macsawall/dspic33-mcu/docs/dspic33ev256gm102/Pinout.png

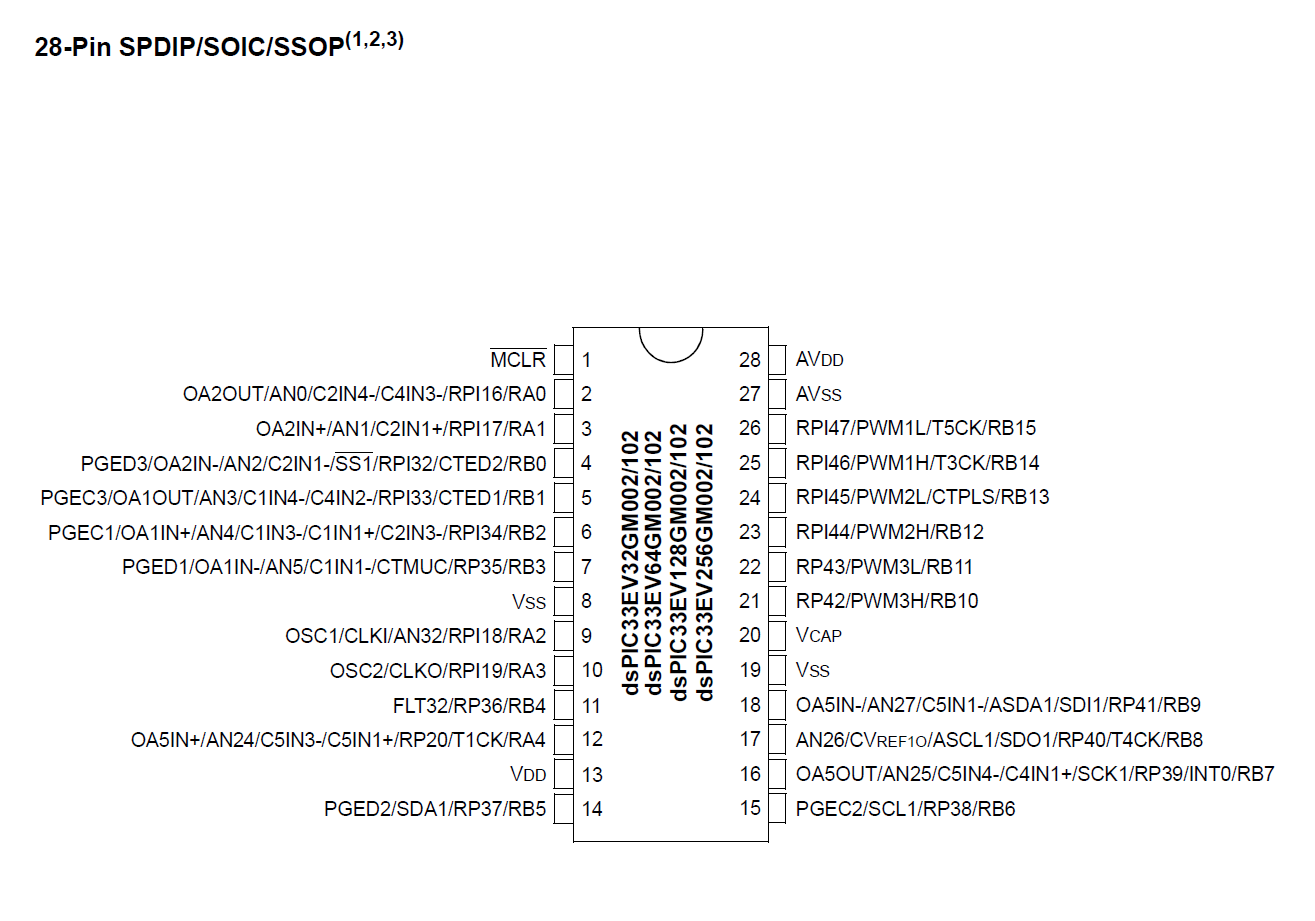
docs/dspic33ev256gm102/Pinout.png
