macsawall/dspic33-mcu/KiCad/dspic33ev256gm102/BOM_dspic33ev256gm102.ods

Reference | Quantity | Value | Footprint | Part # | Link
C2 | 1 | 10uF | Capacitor_SMD:C_1206_3216Metric | CGA5L1X7R1C106K160AC | https://www.digikey.com/product-detail/en/tdk-corporation/CGA5L1X7R1C106K160AC/445-12902-1-ND/3954568
C4 C3 C1 | 3 | 100nF | Capacitor_SMD:C_0603_1608Metric | CL10B104KO8NNNC | https://www.digikey.com/product-detail/en/samsung-electro-mechanics/CL10B104KO8NNNC/1276-1005-1-ND/3889091
D1 D2 | 2 | BLUE LED | LED_SMD:LED_0603_1608Metric | APT1608QBC/D | https://www.digikey.com/product-detail/en/kingbright/APT1608QBC-D/754-1434-1-ND/2163792
D3 D4 D5 | 3 | RED LED | LED_SMD:LED_0603_1608Metric | APT1608SURCK | https://www.digikey.com/product-detail/en/kingbright/APT1608SURCK/754-1123-1-ND/1747840
D6 D7 | 2 | GREEN LED | LED_SMD:LED_0603_1608Metric | APT1608CGCK | https://www.digikey.com/product-detail/en/APT1608CGCK/754-1116-1-ND/1747833/?itemSeq=334077280
J1 J2 J3 J4 J5 J6 J7 | 7 | Conn_01x07 | Connector_PinHeader_2.54mm:PinHeader_1x07_P2.54mm_Vertical | TSW-107-07-L-S | https://www.digikey.com/product-detail/en/samtec-inc/TSW-107-07-L-S/SAM1031-07-ND/1101420
J10 | 1 | USB-PWR | Connector_PinHeader_2.54mm:PinHeader_1x05_P2.54mm_Vertical | 2586 | https://www.digikey.com/product-detail/en/pololu-corporation/2586/2183-2586-ND/10450593
J8 J9 | 2 | FTDI, PICkit3 | Connector_PinHeader_2.54mm:PinHeader_1x06_P2.54mm_Vertical_SMD_Pin1Right | TSM-106-01-L-SV | https://www.digikey.com/product-detail/en/samtec-inc/TSM-106-01-L-SV/SAM10805-ND/2708007
JP2 JP1 | 2 | Jumper_NO_Small | Jumper:SolderJumper-2_P1.3mm_Open_Pad1.0x1.5mm | CRCW06030000Z0EAHP | https://www.digikey.com/product-detail/en/vishay-dale/CRCW06030000Z0EAHP/541-0-0SBCT-ND/2222749
R1 R2 | 2 | 82 | Resistor_SMD:R_0603_1608Metric | CRGP0603F82R | https://www.digikey.com/product-detail/en/te-connectivity-passive-product/CRGP0603F82R/A130403CT-ND/8578235
R3 R4 R5 | 3 | 150 | Resistor_SMD:R_0603_1608Metric | CRGP0603F150R | https://www.digikey.com/product-detail/en/te-connectivity-passive-product/CRGP0603F150R/A130406CT-ND/8578238
R6 R7 | 2 | 143 | Resistor_SMD:R_0603_1608Metric | CRCW0603143RFKEAHP | https://www.digikey.com/product-detail/en/vishay-dale/CRCW0603143RFKEAHP/541-143SCT-ND/5326821
R8 R9 R10 R11 R12 R13 R14 | 7 | 4.7k | Resistor_SMD:R_0603_1608Metric | CRGP0603F4K7 | https://www.digikey.com/product-detail/en/te-connectivity-passive-product/CRGP0603F4K7/A130424CT-ND/8578256
R15 | 1 | 470 | Resistor_SMD:R_0603_1608Metric | CRCW0603470RFKEAHP | https://www.digikey.com/product-detail/en/vishay-dale/CRCW0603470RFKEAHP/541-470SCT-ND/2826020
R16 | 1 | 10k | Resistor_SMD:R_0603_1608Metric | CRCW060310K0FKEAHP | https://www.digikey.com/product-detail/en/vishay-dale/CRCW060310K0FKEAHP/541-10-0KSCT-ND/2222780
SW1 | 1 | SW_SPST | digikey-footprints:Switch_Tactile_SMD_6x6mm | PTS645SM43SMTR92 LFS | https://www.digikey.com/product-detail/en/c-k/PTS645SM43SMTR92-LFS/CKN9112CT-ND/1146934
SW2 | 1 | SW_SPST | digikey-footprints:Switch_Tactile_SMD_6x6mm | PTS645SK50SMTR92 LFS | https://www.digikey.com/product-detail/en/c-k/PTS645SK50SMTR92-LFS/CKN9087CT-ND/1146813
SW3 | 1 | SW_SPST | digikey-footprints:Switch_Tactile_SMD_6x6mm | PTS645SL50SMTR92 LFS | https://www.digikey.com/product-detail/en/c-k/PTS645SL50SMTR92-LFS/CKN9088CT-ND/1146811
SW4 | 1 | SW_DIP_x04 | Button_Switch_SMD:SW_DIP_SPSTx04_Slide_9.78x12.34mm_W8.61mm_P2.54mm | 1-1825059-7 | https://www.digikey.com/product-detail/en/te-connectivity-alcoswitch-switches/1-1825059-7/1-1825059-7-ND/1202121
U1 | 1 | dspic33ev256gm102 | Package_SO:SSOP-28_5.3x10.2mm_P0.65mm | dsPIC33EV256GM102-E/SS | https://www.mouser.com/ProductDetail/Microchip-Technology/dsPIC33EV256GM102-E-SS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
 | 4 |  | HEX STANDOFF #4-40 NYLON ½" | 1902C | https://www.digikey.com/product-detail/en/keystone-electronics/1902C/36-1902C-ND/61868
 | 1 |  | ENCLOSURE | CU-1941 | https://www.digikey.com/product-detail/en/CU-1941/377-2068-ND/439228/?itemSeq=334078929
