macsawall/dspic33-mcu/KiCad/dspic33ev256gm102/dspic33ev256gm102.kicad_pcb

## KiCad design KiCad/dspic33ev256gm102/dspic33ev256gm102.kicad_pcb (2021-11-13)

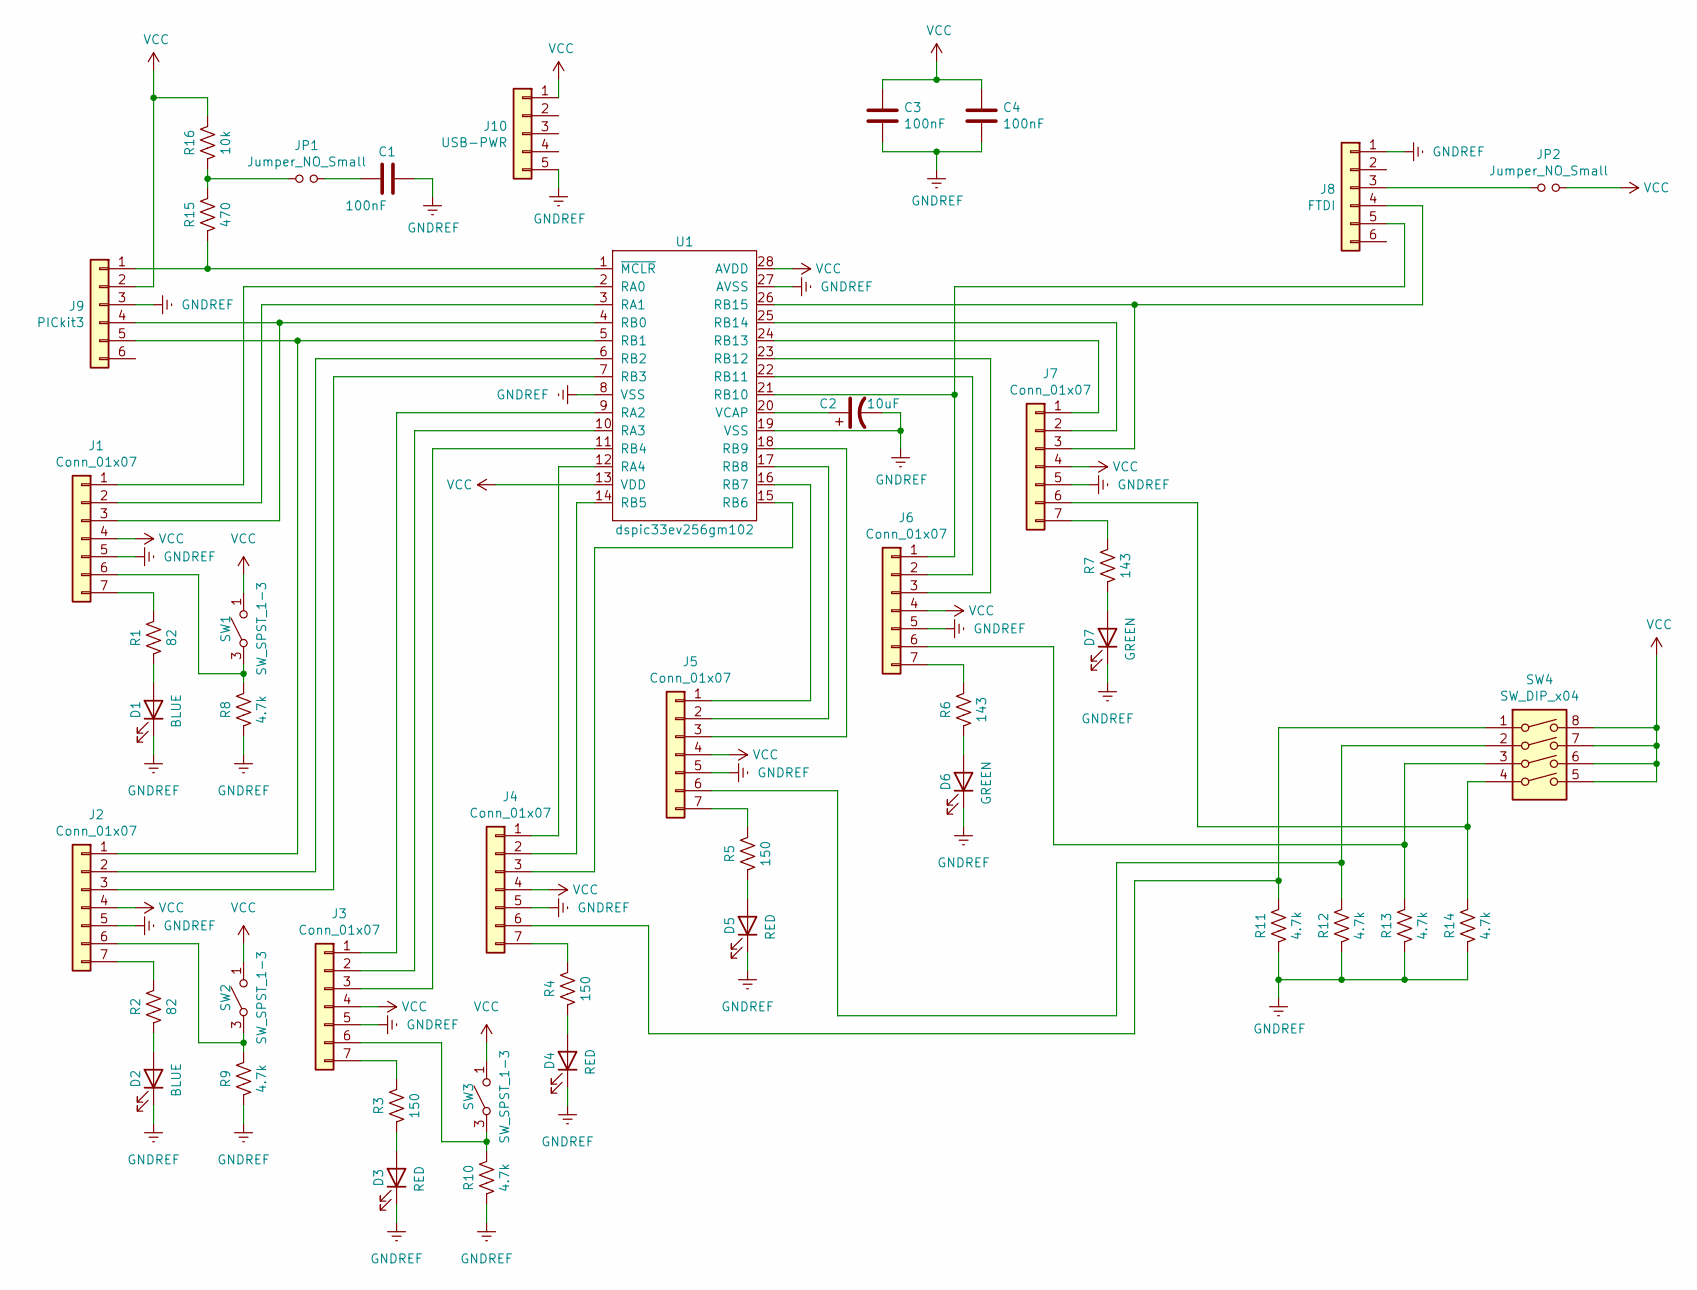
[picture p2: schematic dspic33ev256gm102.sch, DSPIC33EV256GM102 BREAKOUT]

Parts:
C1, C3, C4: 100nF; C_0603_1608Metric
C2: 10uF; C_1206_3216Metric
D1, D2: BLUE; LED_0603_1608Metric
D3, D4, D5: RED; LED_0603_1608Metric
D6, D7: GREEN; LED_0603_1608Metric
J1, J2, J3, J4, J5, J6, J7: Conn_01x07; PinHeader_1x07_P2.54mm_Vertical
J8: FTDI; PinHeader_1x06_P2.54mm_Vertical_SMD_Pin1Right
J9: PICkit3; PinHeader_1x06_P2.54mm_Vertical_SMD_Pin1Right
J10: USB-PWR; PinHeader_1x05_P2.54mm_Vertical
JP1, JP2: Jumper_NO_Small; R_0603_1608Metric
R1, R2: 82; R_0603_1608Metric
R3, R4, R5: 150; R_0603_1608Metric
R6, R7: 143; R_0603_1608Metric
R8, R9, R10, R11, R12, R13, R14: 4.7k; R_0603_1608Metric
R15: 470; R_0603_1608Metric
R16: 10k; R_0603_1608Metric
SW1, SW2, SW3: SW_SPST_1-3; Switch_Tactile_SMD_6x6mm
SW4: SW_DIP_x04; SW_DIP_SPSTx04_Slide_6.7x11.72mm_W8.61mm_P2.54mm_LowProfile
U1: dspic33ev256gm102; SSOP-28_5.3x10.2mm_P0.65mm

Connections:
GNDREF: C1.2, C2.2, C3.2, C4.2, D1.1 (K), D2.1 (K), D3.1 (K), D4.1 (K), D5.1 (K), D6.1 (K), D7.1 (K), J1.5, J2.5, J3.5, J4.5, J5.5, J6.5, J7.5, J8.1, J9.3, J10.5, R8.1, R9.1, R10.1, R11.1, R12.1, R13.1, R14.1, U1.8 (VSS), U1.19 (VSS), U1.27 (AVSS)
unnamed: C1.1, JP1.2
unnamed: C2.1, U1.20 (VCAP)
unnamed: D1.2 (A), R1.1
unnamed: D2.2 (A), R2.1
unnamed: D3.2 (A), R3.1
unnamed: D4.2 (A), R4.1
unnamed: D5.2 (A), R5.1
unnamed: D6.2 (A), R6.1
unnamed: D7.2 (A), R7.1
unnamed: J1.1, U1.2 (RA0)
unnamed: J1.2, U1.3 (RA1)
unnamed: J1.3, J9.4, U1.4 (RB0)
unnamed: J1.6, R8.2, SW1.3 (A)
unnamed: J1.7, R1.2
unnamed: J2.1, J9.5, U1.5 (RB1)
unnamed: J2.2, U1.6 (RB2)
unnamed: J2.3, U1.7 (RB3)
unnamed: J2.6, R9.2, SW2.3 (A)
unnamed: J2.7, R2.2
unnamed: J3.1, U1.9 (RA2)
unnamed: J3.2, U1.10 (RA3)
unnamed: J3.3, U1.11 (RB4)
unnamed: J3.6, R10.2, SW3.3 (A)
unnamed: J3.7, R3.2
unnamed: J4.1, U1.12 (RA4)
unnamed: J4.2, U1.14 (RB5)
unnamed: J4.3, U1.15 (RB6)
unnamed: J4.6, R11.2, SW4.1
unnamed: J4.7, R4.2
unnamed: J5.1, U1.16 (RB7)
unnamed: J5.2, U1.17 (RB8)
unnamed: J5.3, U1.18 (RB9)
unnamed: J5.6, R12.2, SW4.2
unnamed: J5.7, R5.2
unnamed: J6.1, J8.5, U1.21 (RB10)
unnamed: J6.2, U1.22 (RB11)
unnamed: J6.3, U1.23 (RB12)
unnamed: J6.6, R13.2, SW4.3
unnamed: J6.7, R6.2
unnamed: J7.1, U1.24 (RB13)
unnamed: J7.2, U1.25 (RB14)
unnamed: J7.3, J8.4, U1.26 (RB15)
unnamed: J7.6, R14.2, SW4.4
unnamed: J7.7, R7.2
unnamed: J8.3, JP2.1
unnamed: J9.1, R15.1, U1.1 (~MCLR)
unnamed: JP1.1, R15.2, R16.1
VCC: C3.1, C4.1, J1.4, J2.4, J3.4, J4.4, J5.4, J6.4, J7.4, J9.2, J10.1, JP2.2, R16.2, SW1.1 (B), SW2.1 (B), SW3.1 (B), SW4.5, SW4.6, SW4.7, SW4.8, U1.13 (VDD), U1.28 (AVDD)

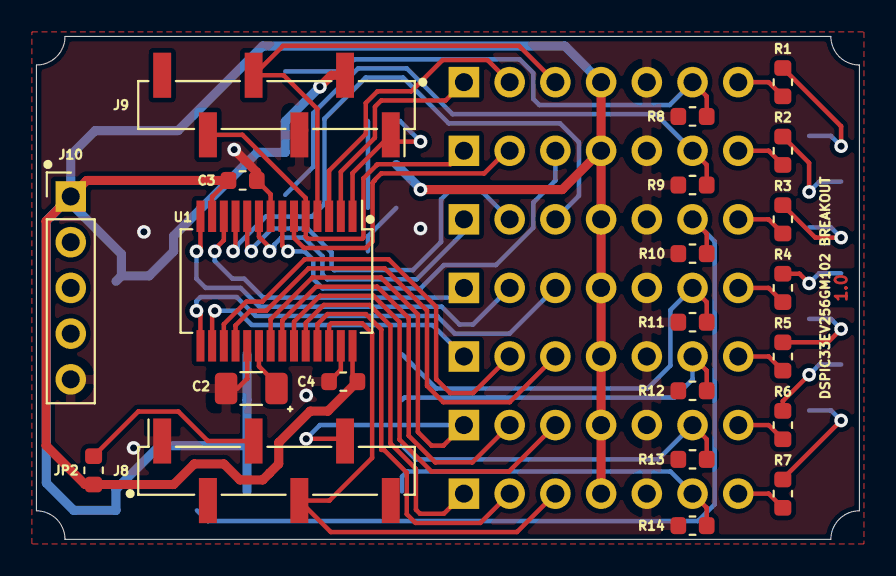
[picture p3: board dspic33ev256gm102.kicad_pcb from above]

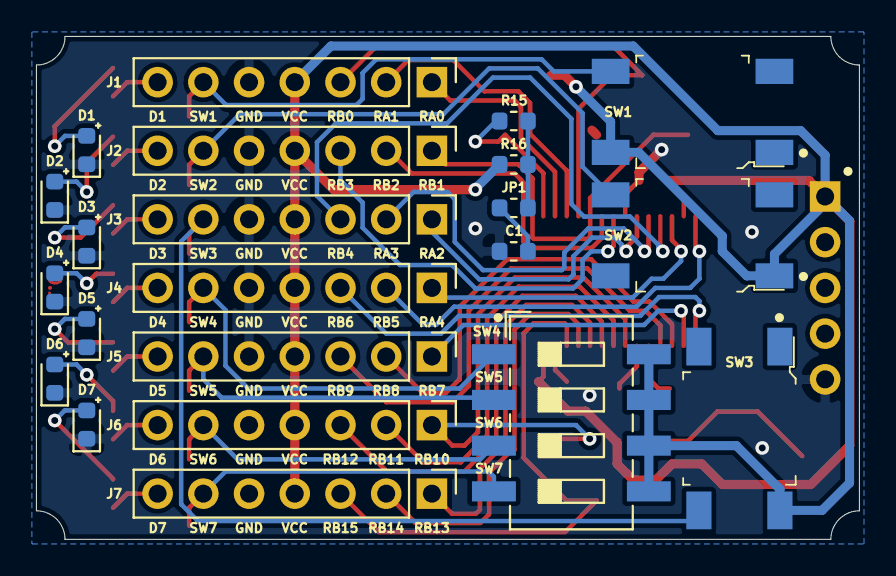
[picture p4: board dspic33ev256gm102.kicad_pcb from below]

Board: 2 copper layers, 45.7 x 27.9 mm, 44 parts (22 on the bottom side), 49 nets.
