macsawall/dspic33-mcu/(commit log)

2020-02-26 Copied in existing UART-LCD project
2020-02-26 Removed LCD code from project main file, leaving only uart; Removed while loop from rx isr
2020-02-27 Fixed uart.x so that received bytes can be passed to uart_tx() as a string; Also reorganized the docs directory
    [main.c]
2020-03-04 initial commit of new project spi-lcd
2020-03-04 Put delay back in spi-lcd to give it time to boot up before sending it commands
2021-11-13 added KiCad PCB project and removed sw testing folder
    [BOM_dspic33ev256gm102.ods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]
2021-11-13 added robotic arm project
